momerobotics/parallelrobots/docs/uj-rendszer-beuzemeles.md

# Manual commissioning guide — moved

All project documentation is maintained in English.
See [Manual commissioning of a completely new system](new-system-commissioning.md)
for the complete procedure and [commissioning record template](commissioning-record-template.md)
for the assembly measurements.

This file preserves an earlier document link.
