momerobotics/parallelrobots/docs/HANDOFF-HU.md

# Supervised operation guide — moved

All project documentation is maintained in English.
See the [Supervised Operation Guide](HANDOFF.md) for the complete procedure.

This file preserves an earlier document link.
