momerobotics/parallelrobots/(commit log)

2026-06-23 v1.0.1 Parallel Mirror Steer-by-Wire v1.0.1
    Patch release correcting CITATION.cff metadata formatting for Zenodo archival.
2026-06-23 Parallel Mirror Steer-by-Wire v1.0.1
    This release contains the same research prototype as v1.0.0, with corrected citation metadata so that the repository can be archived and cited through Zenodo.
    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
2026-07-23 Update MKS ESP32 FOC Mega documentation
2026-07-23 Add current-sense diagnostic firmware
2026-07-23 Document motor and SimpleFOC lineage
2026-07-23 Remove unusable onboard LED code
2026-10-15 Preserve replacement-pair commissioning and supervised force baseline
    Add startup diagnostics, calibration and host regression suites, plus September trial logs, source snapshots and verified recovery binaries. Record replacement-pair constants and the saved knee10 force build. Reconcile current operating documentation with explicit startup and preserve historical handoff instructions.
